rmf-hru-wg/SerialServoTester/SST-Single/SST-Single.png

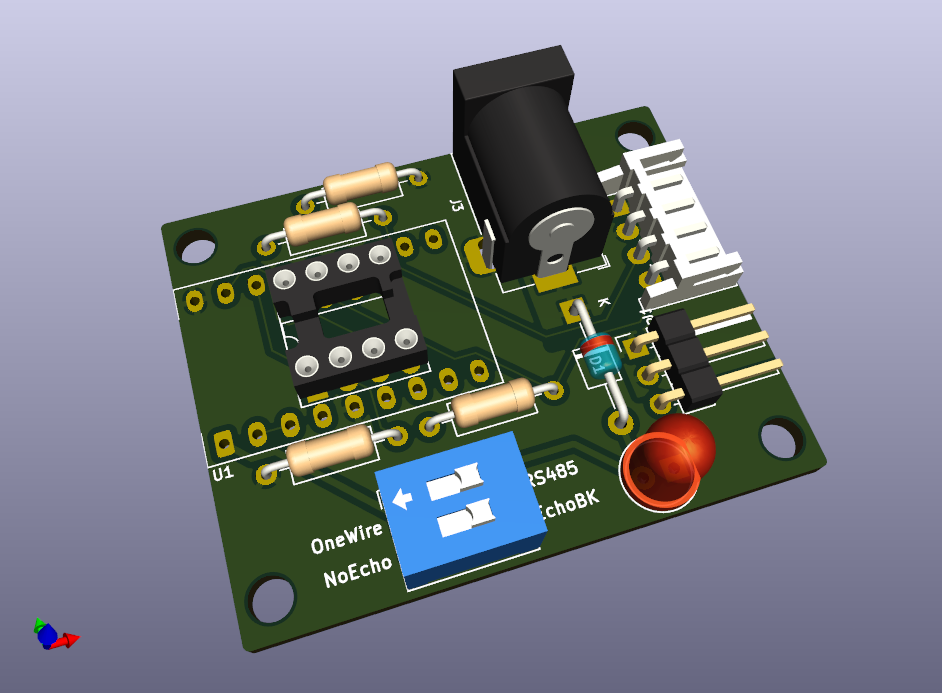
SST-Single/SST-Single.png
