rmf-hru-wg/SerialServoTester/README.md

Serial Servo Tester
===

シリアルサーボを動作させるための回路

* SST-Single: TTLとRS485のコネクタを1つずつ出している。KONDOのDual USBアダプターと同様にサーボの設定に使える。
* SST-SCB: 3ピンTTLのみで24ポート分生やしている。PythonなどPCからロボットを動かすための基板。
