rmf-hru-wg/SerialServoTester/SST-Single/doc/bom_list.xlsx

Reference | Value | Qty | URL | Total
D1 | 11EQS03L | 1 | https://akizukidenshi.com/catalog/g/g111362/ | 1
D2 | OSR6LU5B64A-12V | 1 | https://akizukidenshi.com/catalog/g/g106250/ | 1
J1 | Conn_01x03_Pin | 1 | https://akizukidenshi.com/catalog/g/g115510/ | 1
J2 | Conn_01x04_Pin | 1 | https://www.marutsu.co.jp/pc/i/46603/ | 1
J3 | MJ-179PH | 1 | https://akizukidenshi.com/catalog/g/g106568/ | 1
R1,R2,R3,R4 | 5.1k | 4 | https://akizukidenshi.com/catalog/g/g107832/ | 4
SW1 | EDS102SZ | 1 | https://akizukidenshi.com/catalog/g/g103141/ | 1
U1 | FT231XS-Breakout | 1 | https://www.marutsu.co.jp/pc/i/1557619/ https://www.switch-science.com/products/2499 | 1
U2 | LT1785AxN8 | 1 | https://akizukidenshi.com/catalog/g/g115806/ | 1
 | 8PIN IC Socket | 1 | https://akizukidenshi.com/catalog/g/g100017/ | 1
Number of set | 1
