rmf-hru-wg/SerialServoTester/SST-SCB/SST-SCB.kicad_pcb

## KiCad design SST-SCB/SST-SCB.kicad_pcb (2024-07-20)

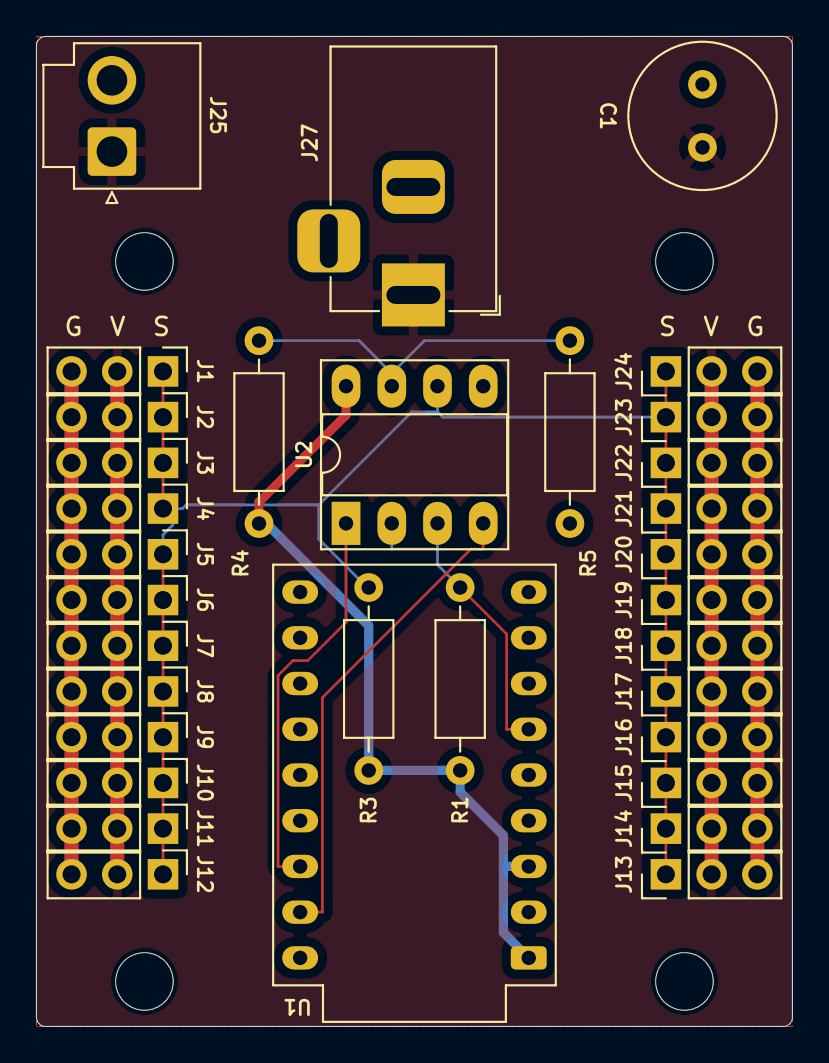
[picture p2: board SST-SCB.kicad_pcb from above]

Board: 2 copper layers, 42.0 x 55.0 mm, 37 parts (0 on the bottom side), 8 nets.

Parts:
C1: C; C_Radial_D8.0mm_H11.5mm_P3.50mm
H1, H2, H3, H4: MountingHole; MountingHole_3.2mm_M3
J1, J2, J3, J4, J5, J6, J7, J8, J9, J10, J11, J12, J13, J14, J15, J16, J17, J18, J19, J20, J21, J22, J23, J24: Conn_01x03_Pin; PinHeader_1x03_P2.54mm_Vertical
J25: Conn_01x02_Pin; JST_VH_B2P-VH_1x02_P3.96mm_Vertical
J27: MJ-179PH; BarrelJack_Horizontal
R1, R3, R4, R5: 5.1k; R_Axial_DIN0207_L6.3mm_D2.5mm_P10.16mm_Horizontal
U1: FT231XS_Breakout; DIP-18_500_ELL
U2: LT1785AxN8; DIP-8_W7.62mm_Socket_LongPads

Connections:
/RS485A: J1.1, J2.1, J3.1, J4.1, J5.1, J6.1, J7.1, J8.1, J9.1, J10.1, J11.1, J12.1, J13.1, J14.1, J15.1, J16.1, J17.1, J18.1, J19.1, J20.1, J21.1, J22.1, J23.1, J24.1, R3.1, U2.6 (A)
/RS485B: R4.1, R5.2, U2.7 (B)
GND: C1.2, J1.3, J2.3, J3.3, J4.3, J5.3, J6.3, J7.3, J8.3, J9.3, J10.3, J11.3, J12.3, J13.3, J14.3, J15.3, J16.3, J17.3, J18.3, J19.3, J20.3, J21.3, J22.3, J23.3, J24.3, J25.2, J27.2, J27.3 (MountPin), R5.1, U1.5 (GND), U1.18 (GND), U2.5 (GND)
unnamed: R1.2, R3.2, R4.2, U1.1 (5V), U1.3 (VCCIO), U2.8 (VCC)
unnamed: R1.1, U1.6 (CBUS0), U2.2 (~RE), U2.3 (DE)
unnamed: U1.16 (RXD), U2.1 (RO)
unnamed: U1.17 (TXD), U2.4 (DI)
VCC: C1.1, J1.2, J2.2, J3.2, J4.2, J5.2, J6.2, J7.2, J8.2, J9.2, J10.2, J11.2, J12.2, J13.2, J14.2, J15.2, J16.2, J17.2, J18.2, J19.2, J20.2, J21.2, J22.2, J23.2, J24.2, J25.1, J27.1
