rmf-hru-wg/SerialServoTester/SST-Single/SST-Single.kicad_pcb

## KiCad design SST-Single/SST-Single.kicad_pcb (2024-05-20)

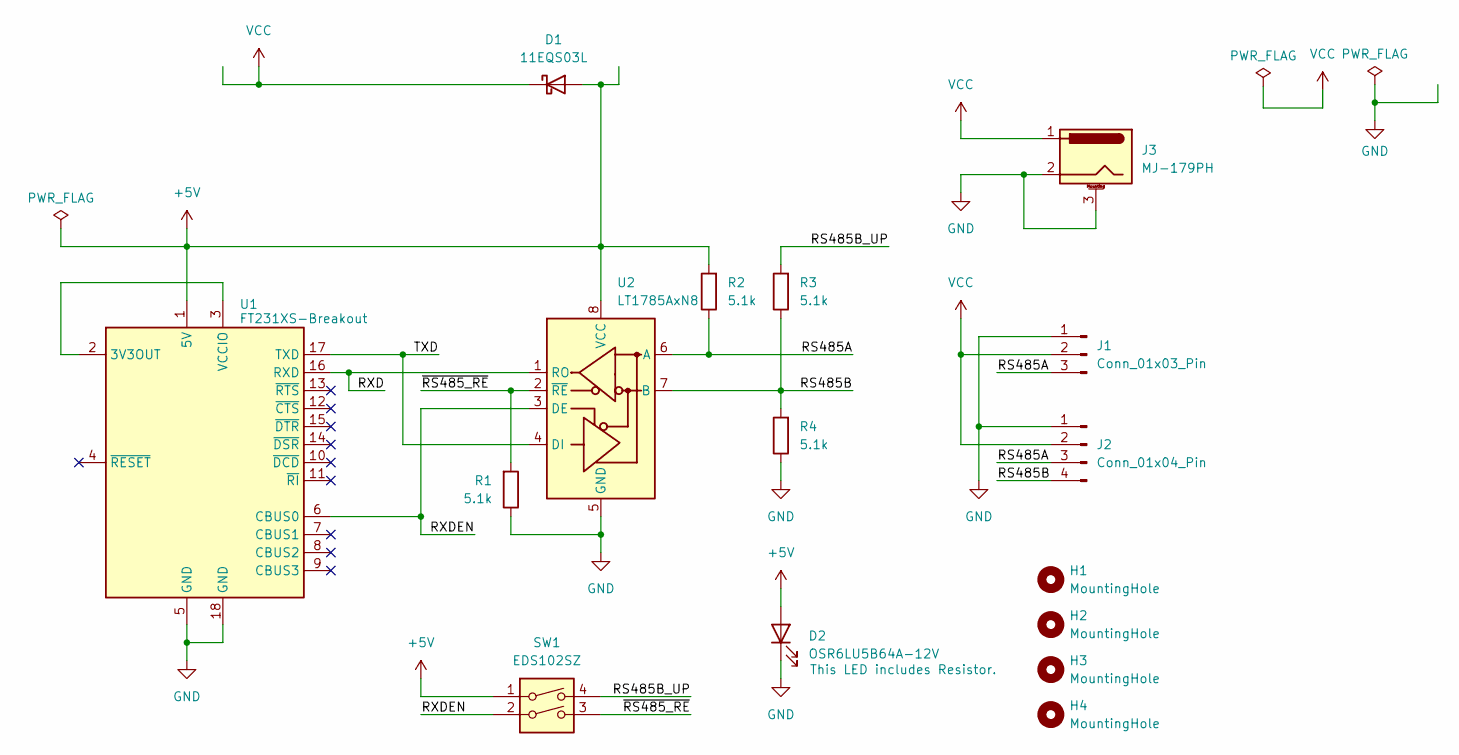
[picture p3: schematic SST-Single.kicad_sch]

Parts:
D1: 11EQS03L; D_T-1_P10.16mm_Horizontal
D2: OSR6LU5B64A-12V; LED_D5.0mm
H1, H2, H3, H4: MountingHole; MountingHole_3.2mm_M3
J1: Conn_01x03_Pin; PinHeader_1x03_P2.54mm_Horizontal
J2: Conn_01x04_Pin; JST_EH_S4B-EH_1x04_P2.50mm_Horizontal
J3: MJ-179PH; BarrelJack_Horizontal
R1, R2, R3, R4: 5.1k; R_Axial_DIN0207_L6.3mm_D2.5mm_P10.16mm_Horizontal
SW1: EDS102SZ; SW_DIP_SPSTx02_Slide_9.78x7.26mm_W7.62mm_P2.54mm
U1: FT231XS-Breakout; DIP-18_500_ELL
U2: LT1785AxN8; DIP-8_W7.62mm_Socket_LongPads

Connections:
+5V: D1.2 (A), D2.2 (A), R2.2, SW1.1, U1.1 (5V), U2.8 (VCC)
/RS485A: J1.3, J2.3, R2.1, U2.6 (A)
/RS485B: J2.4, R3.1, R4.2, U2.7 (B)
/RS485B_UP: R3.2, SW1.4
/RXD: U1.16 (RXD), U2.1 (RO)
/RXDEN: SW1.2, U1.6 (CBUS0), U2.3 (DE)
/TXD: U1.17 (TXD), U2.4 (DI)
/~RS485_RE: R1.2, SW1.3, U2.2 (~RE)
GND: D2.1 (K), J1.1, J2.1, J3.2, J3.3 (MountPin), R1.1, R4.1, U1.5 (GND), U1.18 (GND), U2.5 (GND)
unnamed: U1.2 (3V3OUT), U1.3 (VCCIO)
VCC: D1.1 (K), J1.2, J2.2, J3.1

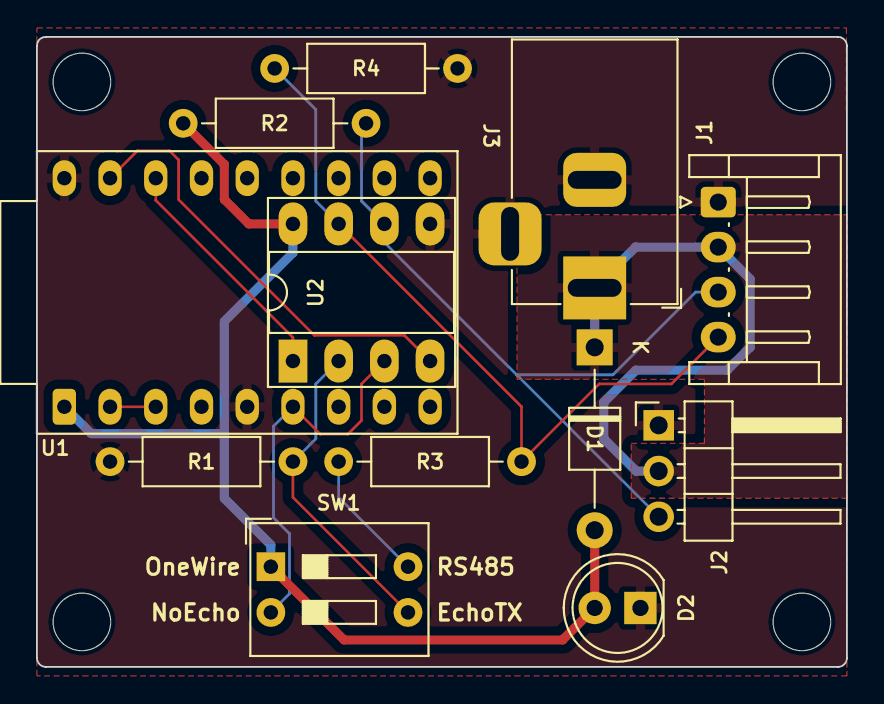
[picture p4: board SST-Single.kicad_pcb from above]

Board: 2 copper layers, 45.0 x 35.0 mm, 16 parts (0 on the bottom side), 11 nets.
