rmf-hru-wg/SerialServoTester/(commit log)

2024-03-16 Update PCB data
    [SerialServoTester.kicad_pcb, SerialServoTester.kicad_sch]
2024-03-23 Update PCB design
    [SerialServoTester.kicad_pcb, SerialServoTester.kicad_sch]
2024-03-25 Move directory from Hardware to Hardware/SST-Single
    [SST-Single.kicad_pcb, SST-Single.kicad_sch]
2024-03-25 Copy from SST-Single to SST-SCB
    [SST-SCB.kicad_pcb, SST-SCB.kicad_sch]
2024-04-14 Update SST-Single Board
    [SST-Single.kicad_pcb]
2024-04-14 Commit Serial Servo Tester for Servo Control Board
    [SST-SCB.kicad_pcb, SST-SCB.kicad_sch]
2024-04-14 Move directories
    [SST-SCB.kicad_pcb, SST-SCB.kicad_sch, SST-Single.kicad_pcb, SST-Single.kicad_sch]
2024-04-14 Add URL test and team logo to the footprint
    [SST-Single.kicad_pcb]
2024-05-08 Add DIP switch to select serial mode
    [SST-Single.kicad_pcb, SST-Single.kicad_sch]
2024-05-13 Remove FET and modify resistors of RS485 DE line
    [SST-Single.kicad_pcb, SST-Single.kicad_sch]
2024-05-13 Update parts layout
    [SST-Single.kicad_pcb]
2024-05-13 Update PCB pattern
    [SST-Single.kicad_pcb]
2024-05-20 Modify to order slightly
    [SST-SCB.kicad_pcb, SST-Single.kicad_pcb]
2024-05-20 Add CC-BY logo
    [SST-Single.kicad_pcb]
2024-06-26 Add documents
    [bom_list.xlsx]
2024-07-20 Fix PCB patterns
    [SST-SCB.kicad_pcb]
